rensselaer-rocket-society/TelemetryUnit/rrs-1000.bmp

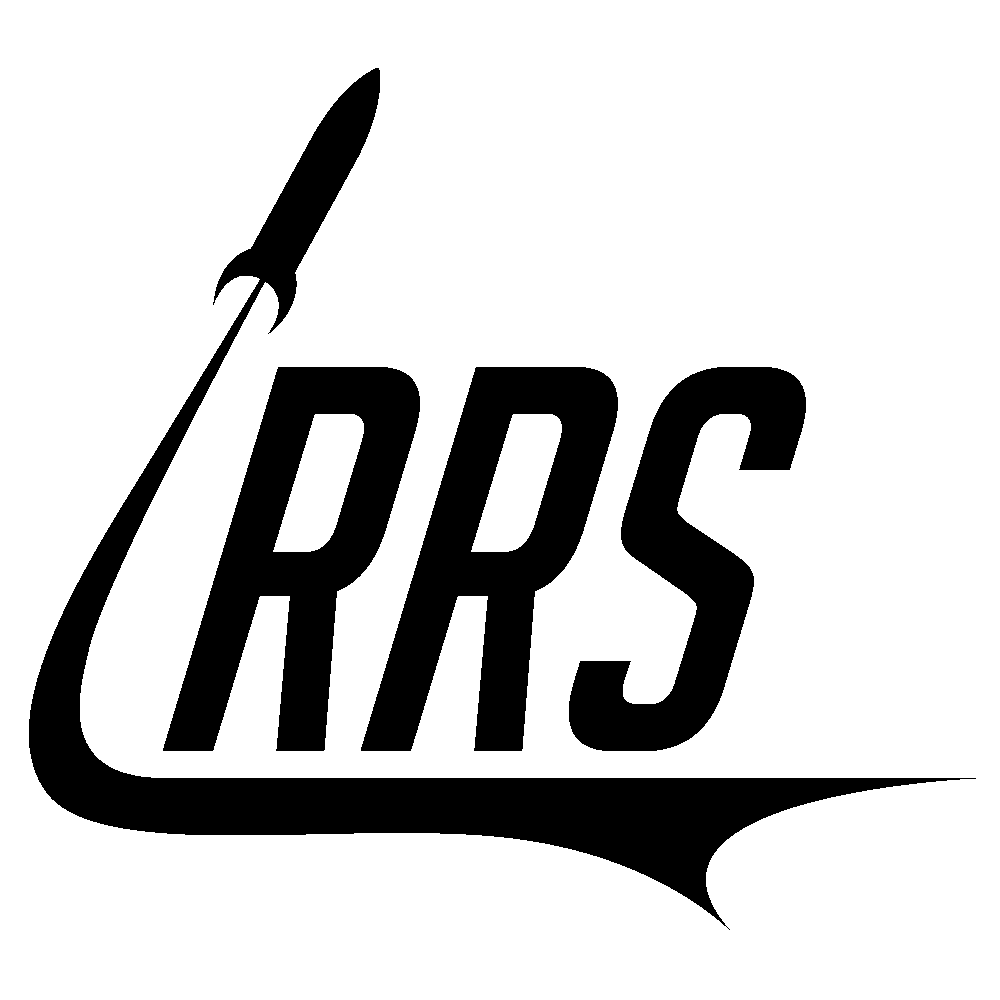
rrs-1000.bmp
