rensselaer-rocket-society/TelemetryUnit/Hardware/Telemetry Unit.brd

## EAGLE design Hardware/Telemetry Unit.brd (2019-10-16)

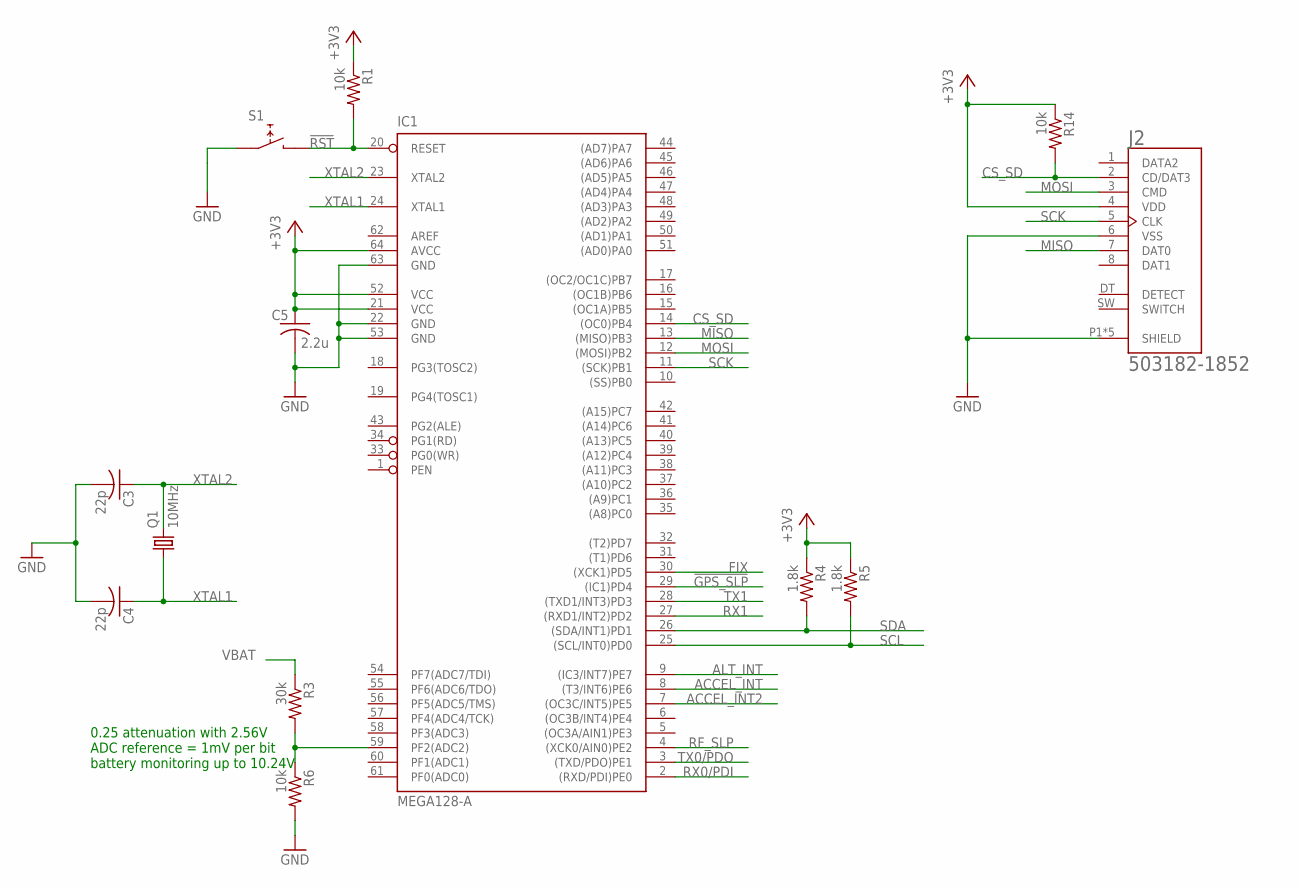
[picture p2: schematic Telemetry Unit.sch, sheet 1, ATMega128 Microcontroller]

Parts:
C3, C4: 22p; C0603
C5: 2.2u; C0603
IC1: MEGA128-A; TQFP64
J2: 503182-1852; MOLEX_503182-1852
Q1: 10MHz; 3.2X2.5_KX-7
R1, R6, R14: 10k; R0603
R3: 30k; R0603
R4, R5: 1.8k; R0603
S1: TACT_SW_4.5MM

Connections:
!GPS_SLP: IC1.29 ((IC1)PD4); also elsewhere on the board
!RST: IC1.20 (RESET), R1.2, S1.P2@1 (1), S1.P2@2 (1); also elsewhere on the board
+3V3: C5.1, IC1.21 (VCC), IC1.52 (VCC), IC1.64 (AVCC), J2.4 (VDD), R1.1, R4.1, R5.1, R14.1; also elsewhere on the board
ACCEL_INT: IC1.8 ((T3/INT6)PE6); also elsewhere on the board
ACCEL_INT2: IC1.7 ((OC3C/INT5)PE5); also elsewhere on the board
ALT_INT: IC1.9 ((IC3/INT7)PE7); also elsewhere on the board
CS_SD: IC1.14 ((OC0)PB4), J2.2 (CD/DAT3), R14.2
FIX: IC1.30 ((XCK1)PD5); also elsewhere on the board
GND: C3.2, C4.2, C5.2, IC1.22 (GND), IC1.53 (GND), IC1.63 (GND), J2.6 (VSS), J2.P1 (SHIELD), J2.P2 (SHIELD), J2.P3 (SHIELD), J2.P4 (SHIELD), J2.P5 (SHIELD), R6.2, S1.P1@1 (0), S1.P1@2 (0); also elsewhere on the board
MISO: IC1.13 ((MISO)PB3), J2.7 (DAT0)
MOSI: IC1.12 ((MOSI)PB2), J2.3 (CMD)
unnamed: IC1.59 (PF2(ADC2)), R3.2, R6.1
RF_SLP: IC1.4 ((XCK0/AIN0)PE2); also elsewhere on the board
RX0/PDI: IC1.2 ((RXD/PDI)PE0); also elsewhere on the board
RX1: IC1.27 ((RXD1/INT2)PD2); also elsewhere on the board
SCK: IC1.11 ((SCK)PB1), J2.5 (CLK); also elsewhere on the board
SCL: IC1.25 ((SCL/INT0)PD0), R5.2; also elsewhere on the board
SDA: IC1.26 ((SDA/INT1)PD1), R4.2; also elsewhere on the board
TX0/PDO: IC1.3 ((TXD/PDO)PE1); also elsewhere on the board
TX1: IC1.28 ((TXD1/INT3)PD3); also elsewhere on the board
VBAT: R3.1; also elsewhere on the board
XTAL1: C4.1, IC1.24 (XTAL1), Q1.1
XTAL2: C3.1, IC1.23 (XTAL2), Q1.3 (2)

Notes on the sheet:
0.25 attenuation with 2.56V ADC reference = 1mV per bit battery monitoring up to 10.24V

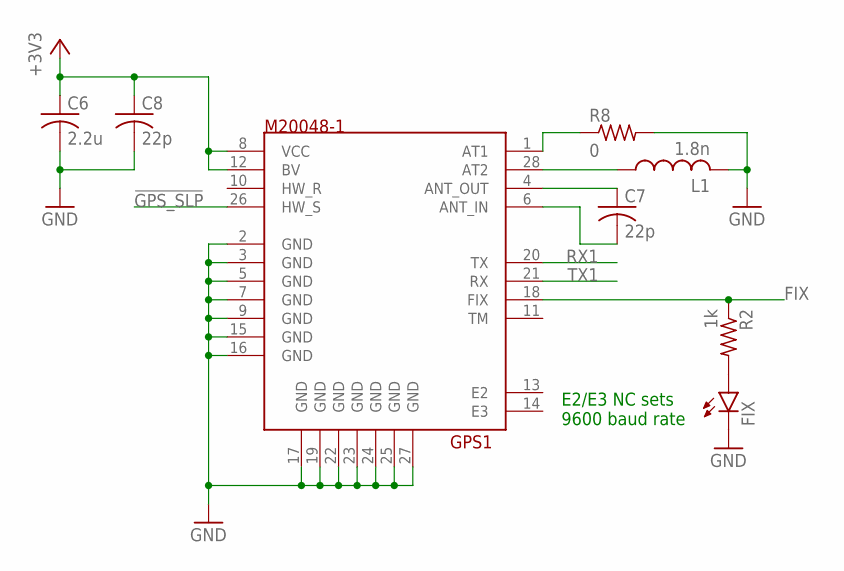
[picture p3: schematic Telemetry Unit.sch, sheet 2, GPS Module]

Parts:
C6: 2.2u; C0603
C7, C8: 22p; C0603
FIX: LEDCHIP-LED0603; CHIP-LED0603
GPS1: M20048-1
L1: 1.8n; L0603
R2: 1k; R0603
R8: 0; R0603

Connections:
!GPS_SLP: GPS1.26 (HW_S); also elsewhere on the board
+3V3: C6.1, C8.1, GPS1.8 (VCC), GPS1.12 (BV); also elsewhere on the board
FIX: GPS1.18 (FIX), R2.1; also elsewhere on the board
GND: C6.2, C8.2, FIX.C, GPS1.2 (GND), GPS1.3 (GND), GPS1.5 (GND), GPS1.7 (GND), GPS1.9 (GND), GPS1.15 (GND), GPS1.16 (GND), GPS1.17 (GND), GPS1.19 (GND), GPS1.22 (GND), GPS1.23 (GND), GPS1.24 (GND), GPS1.25 (GND), GPS1.27 (GND), L1.2, R8.2; also elsewhere on the board
unnamed: C7.1, GPS1.4 (ANT_OUT)
unnamed: C7.2, GPS1.6 (ANT_IN)
unnamed: GPS1.28 (AT2), L1.1
unnamed: FIX.A, R2.2
unnamed: GPS1.1 (AT1), R8.1
RX1: GPS1.20 (TX); also elsewhere on the board
TX1: GPS1.21 (RX); also elsewhere on the board

Notes on the sheet:
E2/E3 NC sets 9600 baud rate

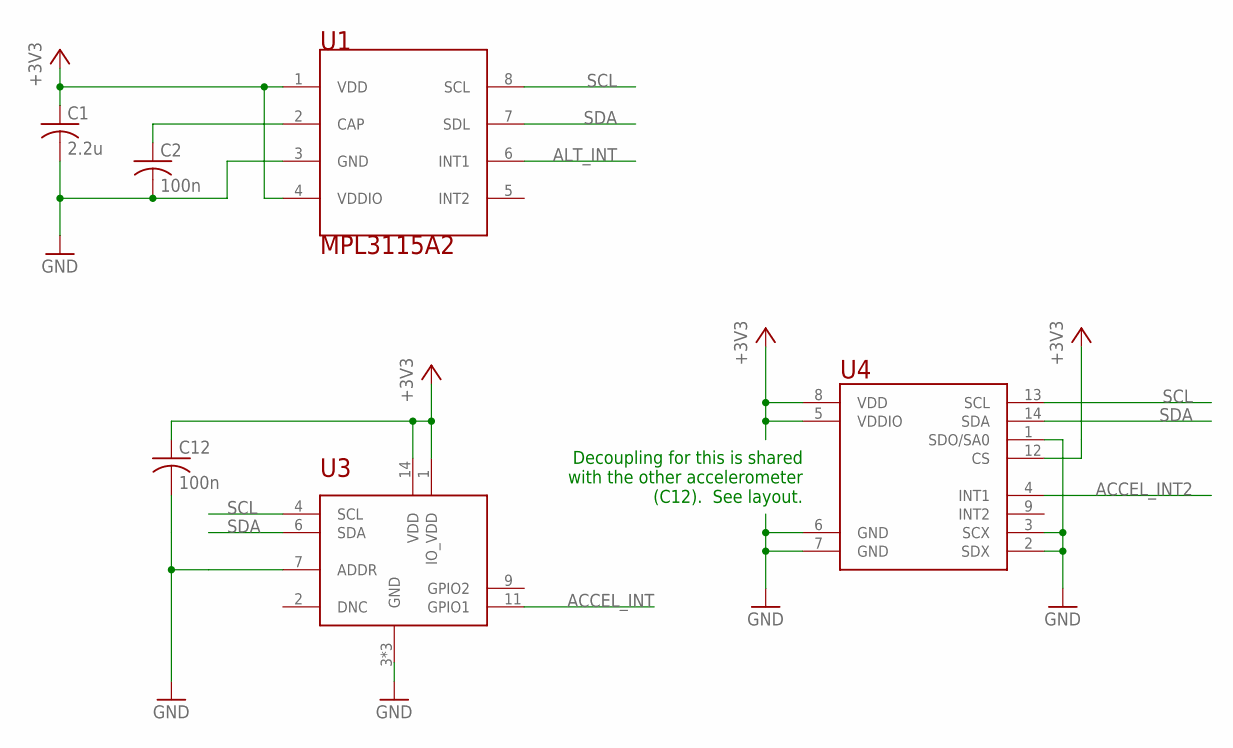
[picture p4: schematic Telemetry Unit.sch, sheet 3, Misc Sensing]

Parts:
C1: 2.2u; C0603
C2, C12: 100n; C0603
U1: MPL3115A2; LGA8
U3: KMX63-1055; LGA16_3X3
U4: LSM6DS3; 14-LGA

Connections:
+3V3: C1.1, C12.1, U1.1 (VDD), U1.4 (VDDIO), U3.1 (IO_VDD), U3.14 (VDD), U4.5 (VDDIO), U4.8 (VDD), U4.12 (CS); also elsewhere on the board
ACCEL_INT: U3.11 (GPIO1); also elsewhere on the board
ACCEL_INT2: U4.4 (INT1); also elsewhere on the board
ALT_INT: U1.6 (INT1); also elsewhere on the board
GND: C1.2, C2.2, C12.2, U1.3 (GND), U3.3 (GND), U3.5 (GND), U3.7 (ADDR), U3.12 (GND), U4.1 (SDO/SA0), U4.2 (SDX), U4.3 (SCX), U4.6 (GND), U4.7 (GND); also elsewhere on the board
unnamed: C2.1, U1.2 (CAP)
SCL: U1.8 (SCL), U3.4 (SCL), U4.13 (SCL); also elsewhere on the board
SDA: U1.7 (SDL), U3.6 (SDA), U4.14 (SDA); also elsewhere on the board

Notes on the sheet:
Decoupling for this is shared with the other accelerometer (C12). See layout.

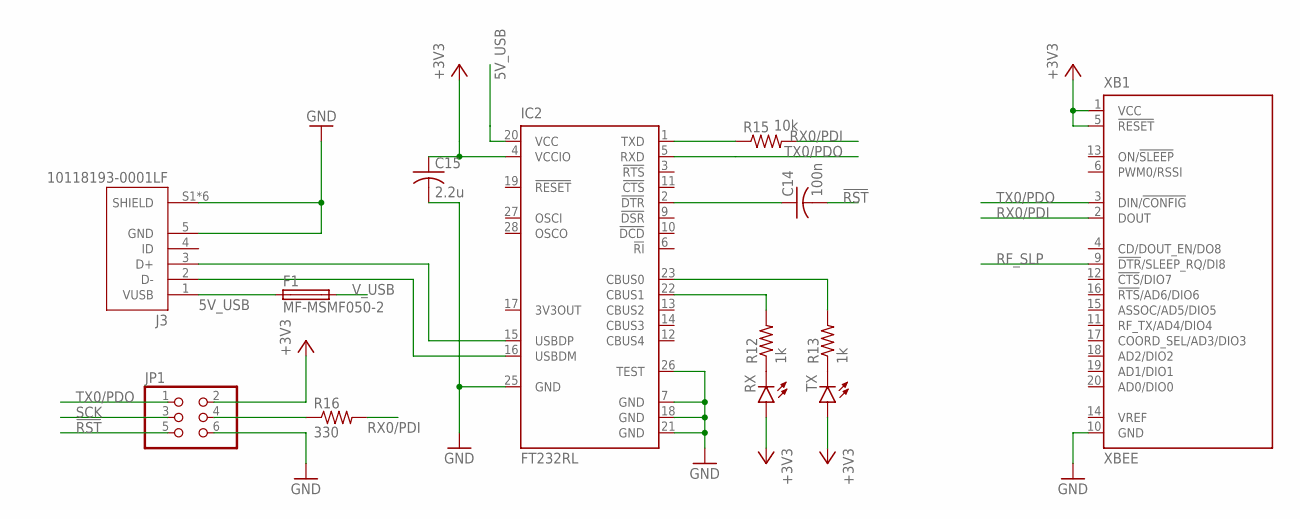
[picture p5: schematic Telemetry Unit.sch, sheet 4, XBee/Programmer]

Parts:
C14: 100n; C0603
C15: 2.2u; C0603
F1: MF-MSMF050-2; FUSM1812X02
IC2: FT232RL; SSOP28
J3: 10118193-0001LF; FCI_10118193-0001LF
JP1: PINHD-2X3; 2X03
R12, R13: 1k; R0603
R15: 10k; R0603
R16: 330; R0603
RX: LEDCHIP-LED0603; CHIP-LED0603
TX: LEDCHIP-LED0603; CHIP-LED0603
XB1: XBEE

Connections:
5V_USB: F1.1, IC2.20 (VCC), J3.1 (VUSB)
!RST: C14.2, JP1.5; also elsewhere on the board
+3V3: C15.1, IC2.4 (VCCIO), JP1.2, RX.A, TX.A, XB1.1 (VCC), XB1.5 (!RESET); also elsewhere on the board
GND: C15.2, IC2.7 (GND), IC2.18 (GND), IC2.21 (GND), IC2.25 (GND), IC2.26 (TEST), J3.5 (GND), J3.S1 (SHIELD), J3.S2 (SHIELD), J3.S3 (SHIELD), J3.S4 (SHIELD), J3.S5 (SHIELD), J3.S6 (SHIELD), JP1.6, XB1.10 (GND); also elsewhere on the board
unnamed: IC2.16 (USBDM), J3.2 (D-)
unnamed: IC2.15 (USBDP), J3.3 (D+)
unnamed: R12.1, RX.C
unnamed: C14.1, IC2.2 (!DTR)
unnamed: R13.1, TX.C
unnamed: IC2.22 (CBUS1), R12.2
unnamed: IC2.23 (CBUS0), R13.2
unnamed: IC2.1 (TXD), R15.1
PDI: JP1.4, R16.1
RF_SLP: XB1.9 (!DTR!/SLEEP_RQ/DI8); also elsewhere on the board
RX0/PDI: R15.2, R16.2, XB1.2 (DOUT); also elsewhere on the board
SCK: JP1.3; also elsewhere on the board
TX0/PDO: IC2.5 (RXD), JP1.1, XB1.3 (DIN/!CONFIG); also elsewhere on the board
V_USB: F1.2; also elsewhere on the board

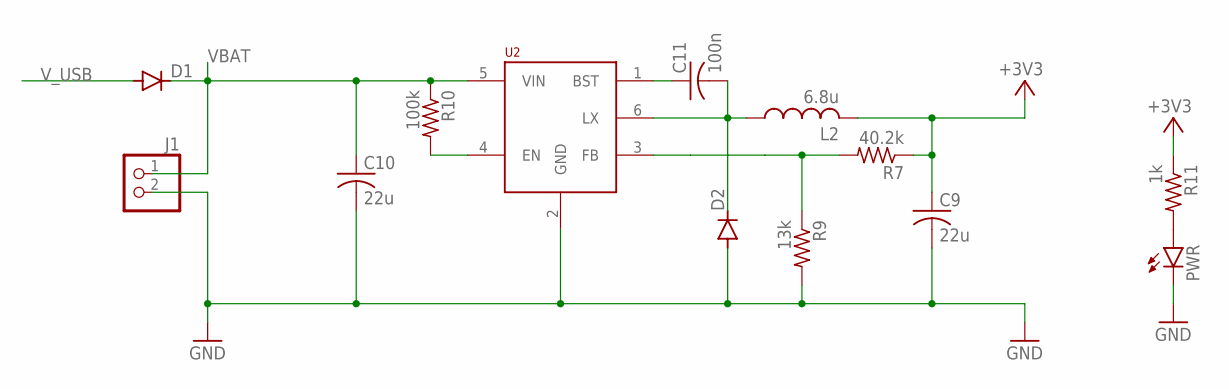
[picture p6: schematic Telemetry Unit.sch, sheet 5, Power Supply]

Parts:
C9, C10: 22u; C0805
C11: 100n; C0603
D1, D2: DIODE-SOD123; SOD123
J1: ST_2X1
L2: 6.8u; L1210
PWR: LEDCHIP-LED0603; CHIP-LED0603
R7: 40.2k; R0603
R9: 13k; R0603
R10: 100k; R0603
R11: 1k; R0603
U2: AOZ1280; TSOT23-6

Connections:
+3V3: C9.1, L2.2, R7.1, R11.1; also elsewhere on the board
GND: C9.2, C10.2, D2.A, J1.2, PWR.C, R9.2, U2.2 (GND); also elsewhere on the board
unnamed: C11.2, D2.C, L2.1, U2.6 (LX)
unnamed: R10.2, U2.4 (EN)
unnamed: R7.2, R9.1, U2.3 (FB)
unnamed: C11.1, U2.1 (BST)
unnamed: PWR.A, R11.2
VBAT: C10.1, D1.C, J1.1, R10.1, U2.5 (VIN); also elsewhere on the board
V_USB: D1.A; also elsewhere on the board

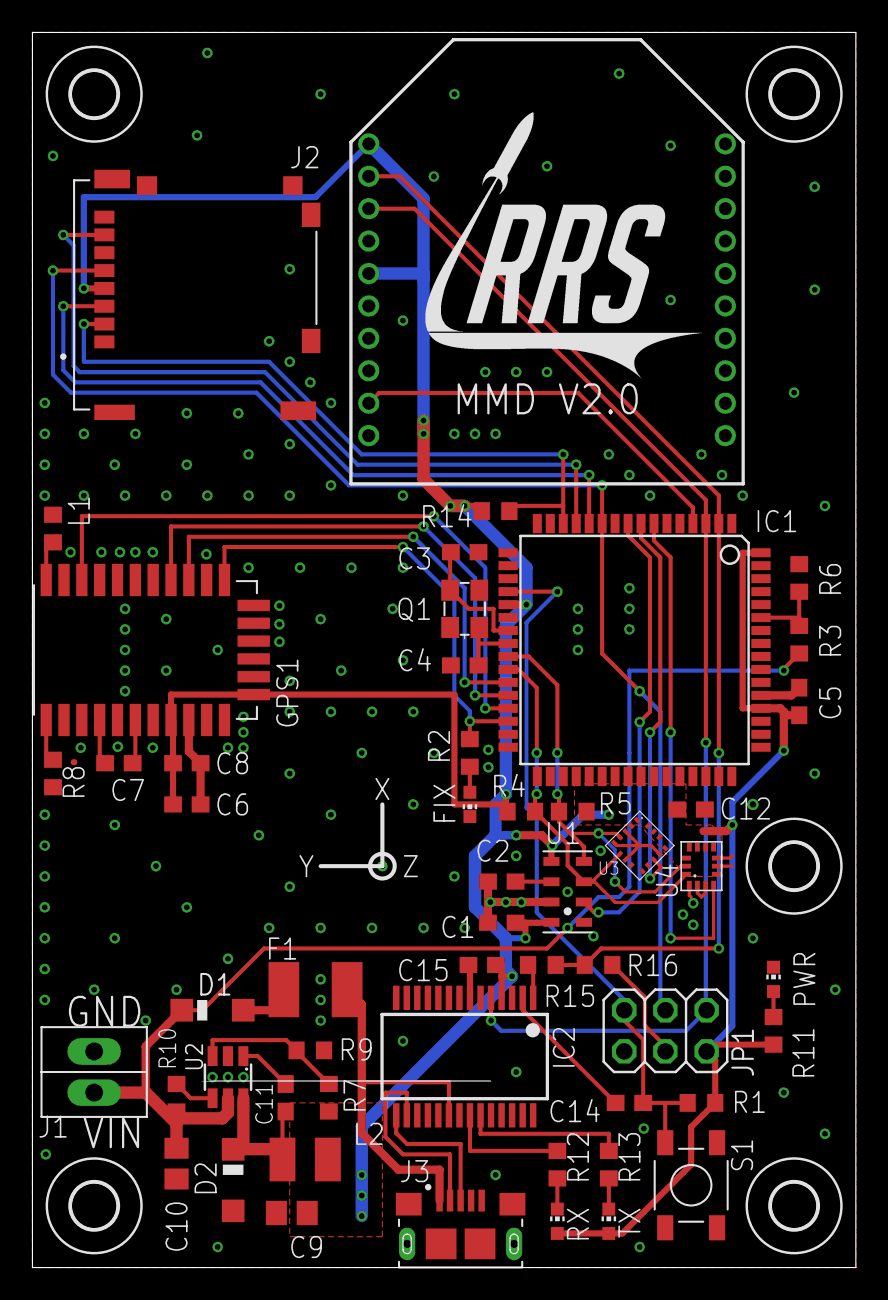
[picture p7: board Telemetry Unit.brd from above]

Board: 2 copper layers, 50.8 x 76.2 mm, 58 parts (0 on the bottom side), 45 nets.

Other parts of the board:
U$1, U$2, U$3, U$4, U$5: 2,8
