rensselaer-rocket-society/TelemetryUnit/(commit log)

2019-01-27 First Pass at Compact Layout
    [Telemetry Unit.brd, Telemetry Unit.sch]
2019-01-29 Switch to screw terminals for battery
    [Telemetry Unit.brd, Telemetry Unit.sch]
2019-01-31 Add accelerometer
    [Telemetry Unit.brd, Telemetry Unit.sch]
2019-02-01 Preliminary Signal Routing
    [Telemetry Unit.brd, Telemetry Unit.sch]
2019-02-01 Apparently hadn't completely saved
    [Telemetry Unit.brd]
2019-02-01 Merging changes into schematics.
    [Telemetry Unit.brd, Telemetry Unit.sch]
2019-02-02 Finished merge, updated layout, added ICSP
    [Telemetry Unit.brd, Telemetry Unit.sch]
2019-02-03 Full Routing Complete?
    [Telemetry Unit.brd, Telemetry Unit.sch]
2019-02-03 Fix USB port nonsense/xBee logo
    [Telemetry Unit.brd, Telemetry Unit.sch]
2019-02-03 Removed via
    [Telemetry Unit.brd]
2019-02-05 Added fuse to usb
    [Telemetry Unit.brd, Telemetry Unit.sch]
2019-02-05 Consolidated resistors and capacitors
    [Telemetry Unit.brd, Telemetry Unit.sch]
2019-02-07 Reroute replaced components and add logo
    [Telemetry Unit.brd]
2019-02-19 Create Arduino Sketch
2019-02-19 Timer2 Configuration
2019-03-23 First pass at I2C UNTESTED
2019-03-24 Debugged I2C, Configure Output and Input pins
2019-03-25 Add modified boards.txt to git, set analog voltage reference
2019-04-09 Packet Serial Fixes + SD First Pass
    [MainSketch.ino, Packet.cpp]
2019-05-18 Fixed CRC byte position
    [Packet.cpp]
2019-05-18 Switch PacketDecoder to real serial port, add temperature logging/streaming
2019-06-02 Save Button, Increased Baud Rate, Serial Error Correction, Favicon
    [LogManager.py, MainSketch.ino, PacketDecoder.py, TelemetryServer.py]
2019-06-03 Do CRC check correctly
    [Packet.cpp, PacketDecoder.py]
2019-06-08 CRC fixes and compatible SD logs
    [MainSketch.ino, Packet.cpp, PacketDecoder.py]
2019-06-09 Most minor updates and some rerouting
    [Telemetry Unit.brd, Telemetry Unit.sch]
2019-06-09 New diode, layer cleanup, update silk
    [Telemetry Unit.brd, Telemetry Unit.sch]
2019-06-09 Replace voltage regulator, reroute all
    [Telemetry Unit.brd, Telemetry Unit.sch]
2019-06-15 Altimeter fixed, battery packets, timestamps, transmit fixed point for smaller packet size
    [LogManager.py, MainSketch.ino, Packet.cpp, PacketDecoder.py]
2019-07-09 Larger board, fix GPS/SD placement
    [Telemetry Unit.brd]
2019-07-10 Wide-Range Accelerometer
    [Telemetry Unit.brd, Telemetry Unit.sch]
2019-07-10 Re-route power
    [Telemetry Unit.brd]
2019-07-11 Reroute remianing signals and stitch grounds
    [Telemetry Unit.brd]
2019-07-11 0 Ohm Tuning Resistor
    [Telemetry Unit.brd, Telemetry Unit.sch]
2019-08-03 Move GPS to long edge. Much rerouting. Shrunk board 0.25"
    [Telemetry Unit.brd, Telemetry Unit.sch]
2019-08-03 Update EAGLE and improve silkscreen
    [Telemetry Unit.brd, Telemetry Unit.sch]
2019-08-03 Stitching vias for rest of board
    [Telemetry Unit.brd]
2019-09-18 Switch Accelerometer
    [Telemetry Unit.brd, Telemetry Unit.sch]
2019-09-19 Add ability to generate files for each sensor series
2019-09-26 Layout accelerometers
    [Telemetry Unit.brd, Telemetry Unit.sch]
2019-09-28 Removed old comment which was no longer relevant
    [Telemetry Unit.brd, Telemetry Unit.sch]
2019-10-03 Final Rev 2
    [Telemetry Unit.brd, Telemetry Unit.sch]
2019-10-16 Board/Stencil Order Receipts
2020-03-03 Added test flight data folder w/ data from L3 flight
    [JJWB_L3.CSV]
2023-05-01 Bump flask from 1.0.2 to 2.3.2 in /Ground Station
    Bumps [flask](https://github.com/pallets/flask) from 1.0.2 to 2.3.2.
    - [Release notes](https://github.com/pallets/flask/releases)
    - [Changelog](https://github.com/pallets/flask/blob/main/CHANGES.rst)
    - [Commits](https://github.com/pallets/flask/compare/1.0.2...2.3.2)
    ---
    updated-dependencies:
    - dependency-name: flask
    dependency-type: direct:production
    ...
